ZhangStudyLife/AT32F405_IMU/reference/manufacturing/stencil_front/钢网制作说明.txt

仅制作正面锡膏钢网。F_Paste.gtp 为实际开口层；Edge_Cuts.gm1 仅为板框定位参考，不作为钢网开口。插件焊盘、安装孔和过孔不开口。不包含 PCB 钻孔文件。按原始 1:1 尺寸制作。
