ZhangStudyLife/AT32F405_IMU/software/MahonyAhrs.c

/*
 * 本文件属于第21届全国大学生智能汽车竞赛飞跃赛区全国冠军团队的开源代码。
 *
 * 代码总仓库：
 * https://github.com/ZhangStudyLife/HDUASC-SmartCar-21st-FlyOverMinefield
 *
 * 作者/维护者：杭电张跃哲
 * 作者主页：https://github.com/ZhangStudyLife/
 *
 * 本项目代码遵循 GNU GPL v3.0 或更高版本。
 * 转载、修改或再发布时，请保留本声明、作者署名和仓库链接，
 * 并按照许可证要求标明修改内容。
 *
 * 本文件中的第三方代码，其版权和许可证以原始声明及对应目录的 LICENSE 为准。
 */
/* AT32 optimization: shared PT1 gain, one accel normalization, direct Euler
 * output. Original gains, gates, exponential quaternion step and validation
 * are retained. No fast inverse-square-root or approximate trig functions. */
#pragma STDC FP_CONTRACT OFF
#include "MahonyAhrs.h"

#include <math.h>

/* 本地差异层: Mahony 解算前对 Z 轴陀螺输入施加对称死区，单位 dps */
#define MAHONY_GYRO_Z_DEADBAND_DPS  0.2f

static float Mahony_Clamp(float value, float min_value, float max_value)
{
    if (value < min_value)
    {
        return min_value;
    }

    if (value > max_value)
    {
        return max_value;
    }

    return value;
}

/*
 * 函数名: Mahony_ApplyDeadband
 * 功能: 对输入量施加对称死区，小于等于死区阈值时直接归零
 * 输入参数:
 *   value    - 输入值
 *   deadband - 死区阈值，要求为非负
 * 返回值:
 *   死区处理后的结果
 */
static float Mahony_ApplyDeadband(float value, float deadband)
{
    if (fabsf(value) <= fabsf(deadband))
    {
        return 0.0f;
    }

    return value;
}

static inline uint8_t Mahony_IsFinite(float value)
{
    /* Ordered comparisons reject NaN and infinity without fast-math. */
    return fabsf(value) <= 1000000.0f;
}

static float Mahony_VectorMagnitudeSquared(float x, float y, float z)
{
    return x * x + y * y + z * z;
}

static float Mahony_VectorMagnitude(float x, float y, float z)
{
    float mag_sq = Mahony_VectorMagnitudeSquared(x, y, z);

    if (mag_sq < MAHONY_VECTOR_NORM_MIN)
    {
        return 0.0f;
    }

    return sqrtf(mag_sq);
}

static void Mahony_QuaternionNormalize(float *q0, float *q1, float *q2, float *q3)
{
    float norm = sqrtf((*q0) * (*q0) + (*q1) * (*q1) + (*q2) * (*q2) + (*q3) * (*q3));

    if (norm < MAHONY_VECTOR_NORM_MIN)
    {
        *q0 = 1.0f;
        *q1 = 0.0f;
        *q2 = 0.0f;
        *q3 = 0.0f;
        return;
    }

    norm = 1.0f / norm;
    *q0 *= norm;
    *q1 *= norm;
    *q2 *= norm;
    *q3 *= norm;
}

static uint8_t Mahony_QuaternionIsValid(float q0, float q1, float q2, float q3)
{
    float norm_sq;

    /* The squared norm rejects NaN/Inf and out-of-range components too. */
    norm_sq = q0 * q0 + q1 * q1 + q2 * q2 + q3 * q3;
    return norm_sq >= 0.5f && norm_sq <= 1.5f;
}

static void Mahony_UpdateStaticState(MahonyAhrs_t *ahrs, float gyro_abs_dps, float accel_mag)
{
    float acc_err_g = fabsf(accel_mag - 1.0f);

    /* 本地差异层: 该静止判定供机体侧逻辑使用，不参与 iNav 主 AHRS 公式本身 */

    if ((gyro_abs_dps < MAHONY_STATIC_GYRO_DPS_TH) &&
        (accel_mag > MAHONY_ACCEL_MIN_MAGNITUDE) &&
        (accel_mag < MAHONY_ACCEL_MAX_MAGNITUDE) &&
        (acc_err_g < MAHONY_STATIC_ACC_ERR_G_TH))
    {
        if (ahrs->static_count < 65535U)
        {
            ahrs->static_count++;
        }
    }
    else
    {
        ahrs->static_count = 0U;
    }

    ahrs->is_static = (ahrs->static_count >= MAHONY_STATIC_LOCK_COUNT) ? 1U : 0U;
}

static float Mahony_CalculateAccelWeightNearness(float accel_mag)
{
    float accel_trust = 1.0f - fabsf(accel_mag - 1.0f) / MAHONY_ACCEL_TRUST_BAND_G;

    return Mahony_Clamp(accel_trust, 0.0f, 1.0f);
}

static float Mahony_CalculateAccelWeightRateIgnore(const MahonyAhrs_t *ahrs)
{
    float gyro_rate_dps;
    float gate_start = MAHONY_ACCEL_IGNORE_RATE_DPS;
    float gate_end = MAHONY_ACCEL_IGNORE_RATE_DPS + MAHONY_ACCEL_IGNORE_SLOPE_DPS;

    if ((gate_start <= 0.0f) || (MAHONY_ACCEL_IGNORE_SLOPE_DPS <= 0.0f))
    {
        return 1.0f;
    }

    gyro_rate_dps = Mahony_VectorMagnitude(ahrs->gyro_lpf_x, ahrs->gyro_lpf_y, ahrs->gyro_lpf_z) * RADIANS_TO_DEGREES;

    if (gyro_rate_dps <= gate_start)
    {
        return 1.0f;
    }

    if (gyro_rate_dps >= gate_end)
    {
        return 0.0f;
    }

    return 1.0f - (gyro_rate_dps - gate_start) / MAHONY_ACCEL_IGNORE_SLOPE_DPS;
}

static void Mahony_ResetQuaternionFromGravity(MahonyAhrs_t *ahrs,
                                              float gravity_x,
                                              float gravity_y,
                                              float gravity_z)
{
    float acc_norm;

    acc_norm = Mahony_VectorMagnitude(gravity_x, gravity_y, gravity_z);
    if (acc_norm < MAHONY_VECTOR_NORM_MIN)
    {
        ahrs->q0 = 1.0f;
        ahrs->q1 = 0.0f;
        ahrs->q2 = 0.0f;
        ahrs->q3 = 0.0f;
        return;
    }

    ahrs->q0 = gravity_z + acc_norm;
    ahrs->q1 = gravity_y;
    ahrs->q2 = -gravity_x;
    ahrs->q3 = 0.0f;
    Mahony_QuaternionNormalize(&ahrs->q0, &ahrs->q1, &ahrs->q2, &ahrs->q3);
}

static void Mahony_CheckAndResetQuaternion(MahonyAhrs_t *ahrs,
                                           float prev_q0,
                                           float prev_q1,
                                           float prev_q2,
                                           float prev_q3,
                                           uint8_t acc_valid,
                                           float gravity_x,
                                           float gravity_y,
                                           float gravity_z)
{
    if (0U != Mahony_QuaternionIsValid(ahrs->q0, ahrs->q1, ahrs->q2, ahrs->q3))
    {
        return;
    }

    if (0U != Mahony_QuaternionIsValid(prev_q0, prev_q1, prev_q2, prev_q3))
    {
        ahrs->q0 = prev_q0;
        ahrs->q1 = prev_q1;
        ahrs->q2 = prev_q2;
        ahrs->q3 = prev_q3;
        return;
    }

    if (acc_valid != 0U)
    {
        Mahony_ResetQuaternionFromGravity(ahrs, gravity_x, gravity_y, gravity_z);
        return;
    }

    ahrs->q0 = 1.0f;
    ahrs->q1 = 0.0f;
    ahrs->q2 = 0.0f;
    ahrs->q3 = 0.0f;
}

void MahonyAhrs_Init(MahonyAhrs_t *ahrs)
{
    ahrs->q0 = 1.0f;
    ahrs->q1 = 0.0f;
    ahrs->q2 = 0.0f;
    ahrs->q3 = 0.0f;

    ahrs->gyro_bias_z_static = 0.0f;

    ahrs->integral_fbx = 0.0f;
    ahrs->integral_fby = 0.0f;

    ahrs->gyro_lpf_x = 0.0f;
    ahrs->gyro_lpf_y = 0.0f;
    ahrs->gyro_lpf_z = 0.0f;

    ahrs->kp = MAHONY_KP_DEFAULT;
    ahrs->ki = MAHONY_KI_DEFAULT;

    ahrs->update_count = 0U;

    ahrs->static_count = 0U;
    ahrs->is_static = 0U;
    ahrs->gyro_lpf_ready = 0U;
}

void MahonyAhrs_Update(MahonyAhrs_t *ahrs,
                       float gyro_x, float gyro_y, float gyro_z,
                       float accel_x, float accel_y, float accel_z,
                       float dt)
{
    float prev_q0;
    float prev_q1;
    float prev_q2;
    float prev_q3;
    float measured_gx;
    float measured_gy;
    float measured_gz;
    float rotation_x;
    float rotation_y;
    float rotation_z;
    float accel_mag;
    float gyro_abs_dps;
    float accel_weight;
    float integral_limit = MAHONY_INTEGRAL_LIMIT_DEG * DEGREES_TO_RADIANS;
    float p_correction_x = 0.0f;
    float p_correction_y = 0.0f;
    float p_correction_z = 0.0f;
    float gravity_x = 0.0f;
    float gravity_y = 0.0f;
    float gravity_z = 0.0f;
    uint8_t acc_valid = 0U;

    /* Port: reject invalid samples before any state is modified. */
    if (!Mahony_IsFinite(dt) || dt <= 0.0f ||
        !Mahony_IsFinite(gyro_x) || !Mahony_IsFinite(gyro_y) || !Mahony_IsFinite(gyro_z) ||
        !Mahony_IsFinite(accel_x) || !Mahony_IsFinite(accel_y) || !Mahony_IsFinite(accel_z))
    {
        return;
    }

    /* 先统计当前加速度模长与静止状态，再决定后续权重与 bias 学习 */

    // 算模长
    accel_mag = Mahony_VectorMagnitude(accel_x, accel_y, accel_z);

    // 模长和陀螺绝对值用于静止判定
    gyro_abs_dps = Mahony_VectorMagnitude(gyro_x, gyro_y, gyro_z);
    // 更新静止状态
    Mahony_UpdateStaticState(ahrs, gyro_abs_dps, accel_mag);

    measured_gx = gyro_x * DEGREES_TO_RADIANS;
    measured_gy = gyro_y * DEGREES_TO_RADIANS;
    measured_gz = gyro_z * DEGREES_TO_RADIANS;

    if (ahrs->gyro_lpf_ready == 0U)
    {
        ahrs->gyro_lpf_x = measured_gx;
        ahrs->gyro_lpf_y = measured_gy;
        ahrs->gyro_lpf_z = measured_gz;
        ahrs->gyro_lpf_ready = 1U;
    }
    else
    {
        /* Same positive dt and fixed cutoff on all three axes. */
        float alpha = dt / (1.0f / (2.0f * 3.14159265359f * MAHONY_ROTATION_LPF_HZ) + dt);
        ahrs->gyro_lpf_x += alpha * (measured_gx - ahrs->gyro_lpf_x);
        ahrs->gyro_lpf_y += alpha * (measured_gy - ahrs->gyro_lpf_y);
        ahrs->gyro_lpf_z += alpha * (measured_gz - ahrs->gyro_lpf_z);
    }

    if (ahrs->is_static != 0U)
    {
        ahrs->gyro_bias_z_static += MAHONY_STATIC_BIAS_Z_ALPHA * (measured_gz - ahrs->gyro_bias_z_static);
        ahrs->gyro_bias_z_static = Mahony_Clamp(ahrs->gyro_bias_z_static, -integral_limit, integral_limit);

    }

    prev_q0 = ahrs->q0;
    prev_q1 = ahrs->q1;
    prev_q2 = ahrs->q2;
    prev_q3 = ahrs->q3;

    rotation_x = measured_gx;
    rotation_y = measured_gy;
    rotation_z = measured_gz - ahrs->gyro_bias_z_static;
    rotation_z = Mahony_ApplyDeadband(rotation_z, MAHONY_GYRO_Z_DEADBAND_DPS * DEGREES_TO_RADIANS);

    if ((accel_mag > MAHONY_ACCEL_MIN_MAGNITUDE) && (accel_mag < MAHONY_ACCEL_MAX_MAGNITUDE))
    {
        float inv_mag = 1.0f / accel_mag;
        gravity_x = accel_x * inv_mag;
        gravity_y = accel_y * inv_mag;
        gravity_z = accel_z * inv_mag;

#if (MAHONY_INPUT_ACCEL_IS_SPECIFIC_FORCE != 0U)
        gravity_x = -gravity_x;
        gravity_y = -gravity_y;
        gravity_z = -gravity_z;
#endif

        acc_valid = 1U; /* Already normalized; magnitude is in (0.3, 3) g. */
    }

    accel_weight = 0.0f;
    if (acc_valid != 0U)
    {
        float acc_weight_nearness = Mahony_CalculateAccelWeightNearness(accel_mag);
        float acc_weight_rate_ignore = Mahony_CalculateAccelWeightRateIgnore(ahrs);

        accel_weight = acc_weight_nearness * acc_weight_rate_ignore;

    }

    if (accel_weight > MAHONY_ACCEL_WEIGHT_MIN)
    {
        float est_gravity_x = 2.0f * (prev_q1 * prev_q3 - prev_q0 * prev_q2);
        float est_gravity_y = 2.0f * (prev_q0 * prev_q1 + prev_q2 * prev_q3);
        float est_gravity_z = prev_q0 * prev_q0 - prev_q1 * prev_q1 - prev_q2 * prev_q2 + prev_q3 * prev_q3;
        float err_x;
        float err_y;
        float err_z;

        err_x = gravity_y * est_gravity_z - gravity_z * est_gravity_y;
        err_y = gravity_z * est_gravity_x - gravity_x * est_gravity_z;
        err_z = gravity_x * est_gravity_y - gravity_y * est_gravity_x;

        if ((ahrs->ki > 0.0f) && (ahrs->is_static != 0U))
        {
            ahrs->integral_fbx += ahrs->ki * err_x * accel_weight * dt;
            ahrs->integral_fby += ahrs->ki * err_y * accel_weight * dt;
            ahrs->integral_fbx = Mahony_Clamp(ahrs->integral_fbx, -integral_limit, integral_limit);
            ahrs->integral_fby = Mahony_Clamp(ahrs->integral_fby, -integral_limit, integral_limit);

        }

        p_correction_x = err_x * ahrs->kp * accel_weight;
        p_correction_y = err_y * ahrs->kp * accel_weight;
        p_correction_z = err_z * ahrs->kp * accel_weight;
    }

    rotation_x += ahrs->integral_fbx + p_correction_x;
    rotation_y += ahrs->integral_fby + p_correction_y;
    rotation_z += p_correction_z;

    {
        float theta_x = rotation_x * 0.5f * dt;
        float theta_y = rotation_y * 0.5f * dt;
        float theta_z = rotation_z * 0.5f * dt;
        float theta_mag_sq = Mahony_VectorMagnitudeSquared(theta_x, theta_y, theta_z);

        if (theta_mag_sq >= MAHONY_QUAT_MIN_UPDATE)
        {
            float delta_q0;
            float delta_q1 = theta_x;
            float delta_q2 = theta_y;
            float delta_q3 = theta_z;

            if (theta_mag_sq < MAHONY_QUAT_SMALL_ANGLE_THRESHOLD)
            {
                float scale = 1.0f - theta_mag_sq / 6.0f;

                delta_q0 = 1.0f - theta_mag_sq / 2.0f;
                delta_q1 *= scale;
                delta_q2 *= scale;
                delta_q3 *= scale;
            }
            else
            {
                float theta_mag = sqrtf(theta_mag_sq);
                float scale = sinf(theta_mag) / theta_mag;

                delta_q0 = cosf(theta_mag);
                delta_q1 *= scale;
                delta_q2 *= scale;
                delta_q3 *= scale;
            }

            ahrs->q0 = prev_q0 * delta_q0 - prev_q1 * delta_q1 - prev_q2 * delta_q2 - prev_q3 * delta_q3;
            ahrs->q1 = prev_q0 * delta_q1 + prev_q1 * delta_q0 + prev_q2 * delta_q3 - prev_q3 * delta_q2;
            ahrs->q2 = prev_q0 * delta_q2 - prev_q1 * delta_q3 + prev_q2 * delta_q0 + prev_q3 * delta_q1;
            ahrs->q3 = prev_q0 * delta_q3 + prev_q1 * delta_q2 - prev_q2 * delta_q1 + prev_q3 * delta_q0;

            Mahony_QuaternionNormalize(&ahrs->q0, &ahrs->q1, &ahrs->q2, &ahrs->q3);
        }
    }

    Mahony_CheckAndResetQuaternion(ahrs,
                                   prev_q0, prev_q1, prev_q2, prev_q3,
                                   acc_valid,
                                   gravity_x, gravity_y, gravity_z);

    ahrs->update_count++;
}

void MahonyAhrs_GetEulerDegrees(const MahonyAhrs_t *ahrs, float euler[3])
{
    float q0 = ahrs->q0, q1 = ahrs->q1, q2 = ahrs->q2, q3 = ahrs->q3;
    euler[0] = atan2f(2.0f * (q0*q1 + q2*q3),
                      1.0f - 2.0f * (q1*q1 + q2*q2)) * RADIANS_TO_DEGREES;
    euler[1] = asinf(Mahony_Clamp(2.0f * (q0*q2 - q3*q1), -1.0f, 1.0f)) * RADIANS_TO_DEGREES;
    euler[2] = atan2f(2.0f * (q0*q3 + q1*q2),
                      1.0f - 2.0f * (q2*q2 + q3*q3)) * RADIANS_TO_DEGREES;
}

void MahonyAhrs_ResetBias(MahonyAhrs_t *ahrs)
{

    ahrs->gyro_bias_z_static = 0.0f;

    ahrs->integral_fbx = 0.0f;
    ahrs->integral_fby = 0.0f;

    ahrs->gyro_lpf_x = 0.0f;
    ahrs->gyro_lpf_y = 0.0f;
    ahrs->gyro_lpf_z = 0.0f;

    ahrs->static_count = 0U;
    ahrs->is_static = 0U;
    ahrs->gyro_lpf_ready = 0U;
}
