ZhangStudyLife/AT32F405_IMU/software/MahonyAhrs.h

/*
 * 本文件属于第21届全国大学生智能汽车竞赛飞跃赛区全国冠军团队的开源代码。
 *
 * 代码总仓库：
 * https://github.com/ZhangStudyLife/HDUASC-SmartCar-21st-FlyOverMinefield
 *
 * 作者/维护者：杭电张跃哲
 * 作者主页：https://github.com/ZhangStudyLife/
 *
 * 本项目代码遵循 GNU GPL v3.0 或更高版本。
 * 转载、修改或再发布时，请保留本声明、作者署名和仓库链接，
 * 并按照许可证要求标明修改内容。
 *
 * 本文件中的第三方代码，其版权和许可证以原始声明及对应目录的 LICENSE 为准。
 */
/********************************************************************
 * 文件    : MahonyAhrs.h
 * 模块    : 姿态融合 - Mahony AHRS 四元数解算
 * 位置    : Estimation/Attitude
 * 职责    :
 *   1) 输入滤波后的机体系角速度(deg/s)与比力(g)
 *   2) 输出姿态四元数与欧拉角
 *   3) 内部计算默认对齐 INAV 纯 6 轴姿态算法
 ********************************************************************/
#ifndef MAHONY_AHRS_H
#define MAHONY_AHRS_H

#include <stdint.h>

/* ======================== 采样率与物理常数 ======================== */
#define MAHONY_SAMPLE_RATE                    1000.0f   /* 姿态解算默认采样率，单位 Hz */
#define MAHONY_SAMPLE_DT                      (1.0f / MAHONY_SAMPLE_RATE) /* 姿态解算默认采样周期，单位 s */
#define DEGREES_TO_RADIANS                    (3.14159265359f / 180.0f)   /* 角度转弧度系数 */
#define RADIANS_TO_DEGREES                    (180.0f / 3.14159265359f)   /* 弧度转角度系数 */

/* ======================== INAV 对齐参数 ======================== */
#define MAHONY_KP_DEFAULT                     0.6f     /* 0531 离线 6轴对比: 全局最贴近 EKF/Madgwick 的姿态拉回力度 */
#define MAHONY_KI_DEFAULT                     0.02f    /* 0531 离线 6轴对比: 静止/低动态时慢速学习 bias */
#define MAHONY_INPUT_ACCEL_IS_SPECIFIC_FORCE  (0U)     /* Port: native axes, +Z-up stationary input is +1g. */
#define MAHONY_ACCEL_MIN_MAGNITUDE            0.30f    /* 0531 离线 6轴对比: 放宽飞行段加计修正下限，单位 g */
#define MAHONY_ACCEL_MAX_MAGNITUDE            3.00f    /* 0531 离线 6轴对比: 放宽飞行段加计修正上限，单位 g */
#define MAHONY_ACCEL_TRUST_BAND_G             0.70f    /* 0531 离线 6轴对比: 全局最优 |acc|-1g 连续降权带宽 */
#define MAHONY_ACCEL_WEIGHT_MIN               0.0f     /* 第一阶段不再额外抬高加计参与门限 */
#define MAHONY_ACCEL_IGNORE_RATE_DPS          12.0f    /* 角速度低于该阈值时加计全权参与 */
#define MAHONY_ACCEL_IGNORE_SLOPE_DPS         18.0f    /* 从全权重退到 0 的角速度过渡带宽 */
#define MAHONY_ROTATION_LPF_HZ                3.0f     /* INAV 6轴默认角速度门控低通，单位 Hz */
#define MAHONY_INTEGRAL_LIMIT_DEG             2.0f     /* INAV 风格积分限幅角度，单位 deg */

/* ======================== 静止检测参数 ======================== */
#define MAHONY_STATIC_GYRO_DPS_TH             1.5f     /* 静止判定角速度阈值，单位 dps */
#define MAHONY_STATIC_ACC_ERR_G_TH            0.08f    /* 静止判定加速度模长误差阈值，单位 g */
#define MAHONY_STATIC_LOCK_COUNT              (100U)   /* 静止判定锁定样本数 */
#define MAHONY_STATIC_BIAS_Z_ALPHA            0.002f   /* 静止时 Z 轴零偏一阶低通学习系数 */

/* ======================== 数值稳定参数 ======================== */
#define MAHONY_VECTOR_NORM_MIN                1e-6f    /* 向量/四元数最小模长阈值 */
#define MAHONY_QUAT_SMALL_ANGLE_THRESHOLD     0.00489898f /* INAV 小角度增量四元数阈值 */
#define MAHONY_QUAT_MIN_UPDATE                1e-20f   /* 四元数增量最小阈值 */

/* ======================== 姿态状态结构体 ======================== */
typedef struct
{
    float q0;                  /* 四元数实部 */
    float q1;                  /* 四元数 i 分量 */
    float q2;                  /* 四元数 j 分量 */
    float q3;                  /* 四元数 k 分量 */

    float gyro_bias_z_static;  /* 保留旧字段，默认不参与姿态更新 */

    float integral_fbx;        /* X 轴积分反馈状态，单位 rad/s */
    float integral_fby;        /* Y 轴积分反馈状态，单位 rad/s */

    float gyro_lpf_x;          /* X 轴角速度门控低通状态，单位 rad/s */
    float gyro_lpf_y;          /* Y 轴角速度门控低通状态，单位 rad/s */
    float gyro_lpf_z;          /* Z 轴角速度门控低通状态，单位 rad/s */

    float kp;                  /* 当前姿态 P 增益 */
    float ki;                  /* 当前姿态 I 增益 */

    uint32_t update_count;     /* 姿态更新计数 */
    uint16_t static_count;     /* 静止连续样本计数 */
    uint8_t is_static;         /* 1=当前姿态输入满足静止条件 */
    uint8_t gyro_lpf_ready;    /* 1=角速度门控低通已初始化 */

} MahonyAhrs_t;

/* Internal attitude core; public board interface is imu.h. */
void MahonyAhrs_Init(MahonyAhrs_t *ahrs);
void MahonyAhrs_Update(MahonyAhrs_t *ahrs,
                       float gyro_x, float gyro_y, float gyro_z,
                       float accel_x, float accel_y, float accel_z, float dt);
void MahonyAhrs_GetEulerDegrees(const MahonyAhrs_t *ahrs, float euler[3]);
void MahonyAhrs_ResetBias(MahonyAhrs_t *ahrs);
#endif
