ZhangStudyLife/AT32F405_IMU/software/platform.h

#ifndef PLATFORM_H
#define PLATFORM_H
#include "at32f402_405.h"
#include <stdint.h>

extern volatile uint32_t heartbeat_ms;
extern uint64_t idle_cycles;
extern uint32_t profile_since;
int platform_init(void);
void platform_idle(void);
__STATIC_FORCEINLINE uint32_t cycles(void)
{
    uint32_t value;
    __COMPILER_BARRIER();
    value = DWT->CYCCNT;
    __COMPILER_BARRIER();
    return value;
}
__STATIC_FORCEINLINE uint32_t micros(void) { return TMR2->cval; }

enum { PROF_ACQUIRE, PROF_DRIVER, PROF_PREPROCESS, PROF_FILTER, PROF_MAHONY,
       PROF_EULER, PROF_CAL_SAMPLE, PROF_CAL_SLICE, PROF_CAL_TOTAL,
       PROF_FRAME, PROF_PROCESS, PROF_IRQ, PROF_SAVE, PROF_UART, PROF_COUNT };
typedef struct {
    uint32_t count, last, min, max;
    uint64_t total;
} Profile;
extern Profile profiles[PROF_COUNT];
__STATIC_FORCEINLINE void profile_add(unsigned stage, uint32_t elapsed)
{
    Profile *p = &profiles[stage];
    if (!p->count || elapsed < p->min) p->min = elapsed;
    if (elapsed > p->max) p->max = elapsed;
    p->last = elapsed;
    p->total += elapsed;
    p->count++;
}
void profile_reset(void);
#endif
