ZhangStudyLife/AT32F405_IMU/(commit log)

2026-11-10 chore: add hardware
    [AT32F405_IMU.kicad_pcb, AT32F405_IMU.kicad_sch]
2026-11-10 chore: add reference
    [AT32F405_IMU-B_Cu.gbr, AT32F405_IMU-B_Mask.gbr, AT32F405_IMU-B_Paste.gbr, AT32F405_IMU-B_Silkscreen.gbr, AT32F405_IMU-Edge_Cuts.gbr, AT32F405_IMU-Edge_Cuts.gm1, AT32F405_IMU-F_Cu.gbr, AT32F405_IMU-F_Mask.gbr]
2026-11-10 feat: add nonblocking AT32 IMU acquisition drivers
2026-11-10 feat: port attitude filters and calibration algorithms
2026-11-10 perf: optimize IMU acquisition and attitude processing
2026-11-10 chore: remove test artifacts and extend ignore rules
    [new_board_capture.csv]
2026-11-13 feat: add UART telemetry, calibration control and fault diagnostics
